PhamChinhCode/F1_PID_Driver_V1/F1_PID_Driver_V1.png

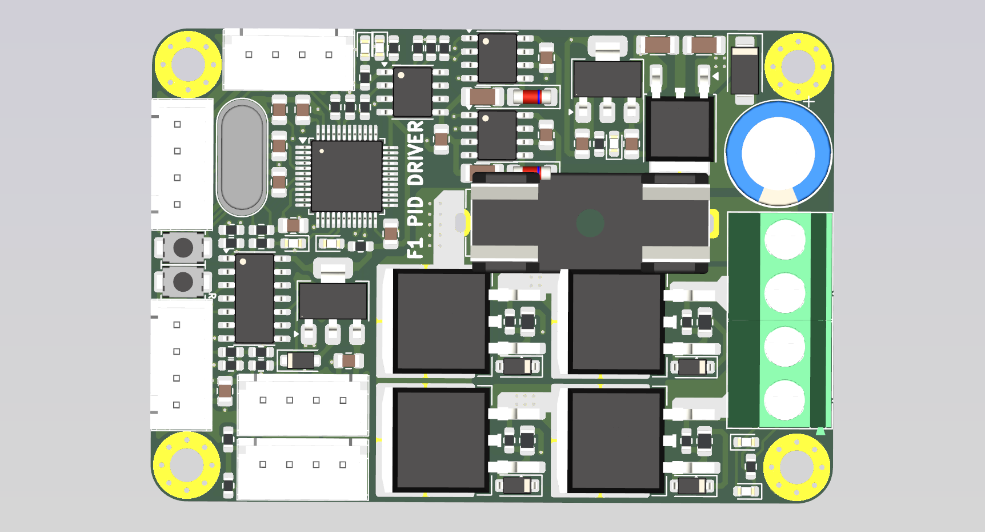
F1_PID_Driver_V1.png
