PhamChinhCode/F1_PID_Driver_V1/F1_PID_Driver_V1.pdf

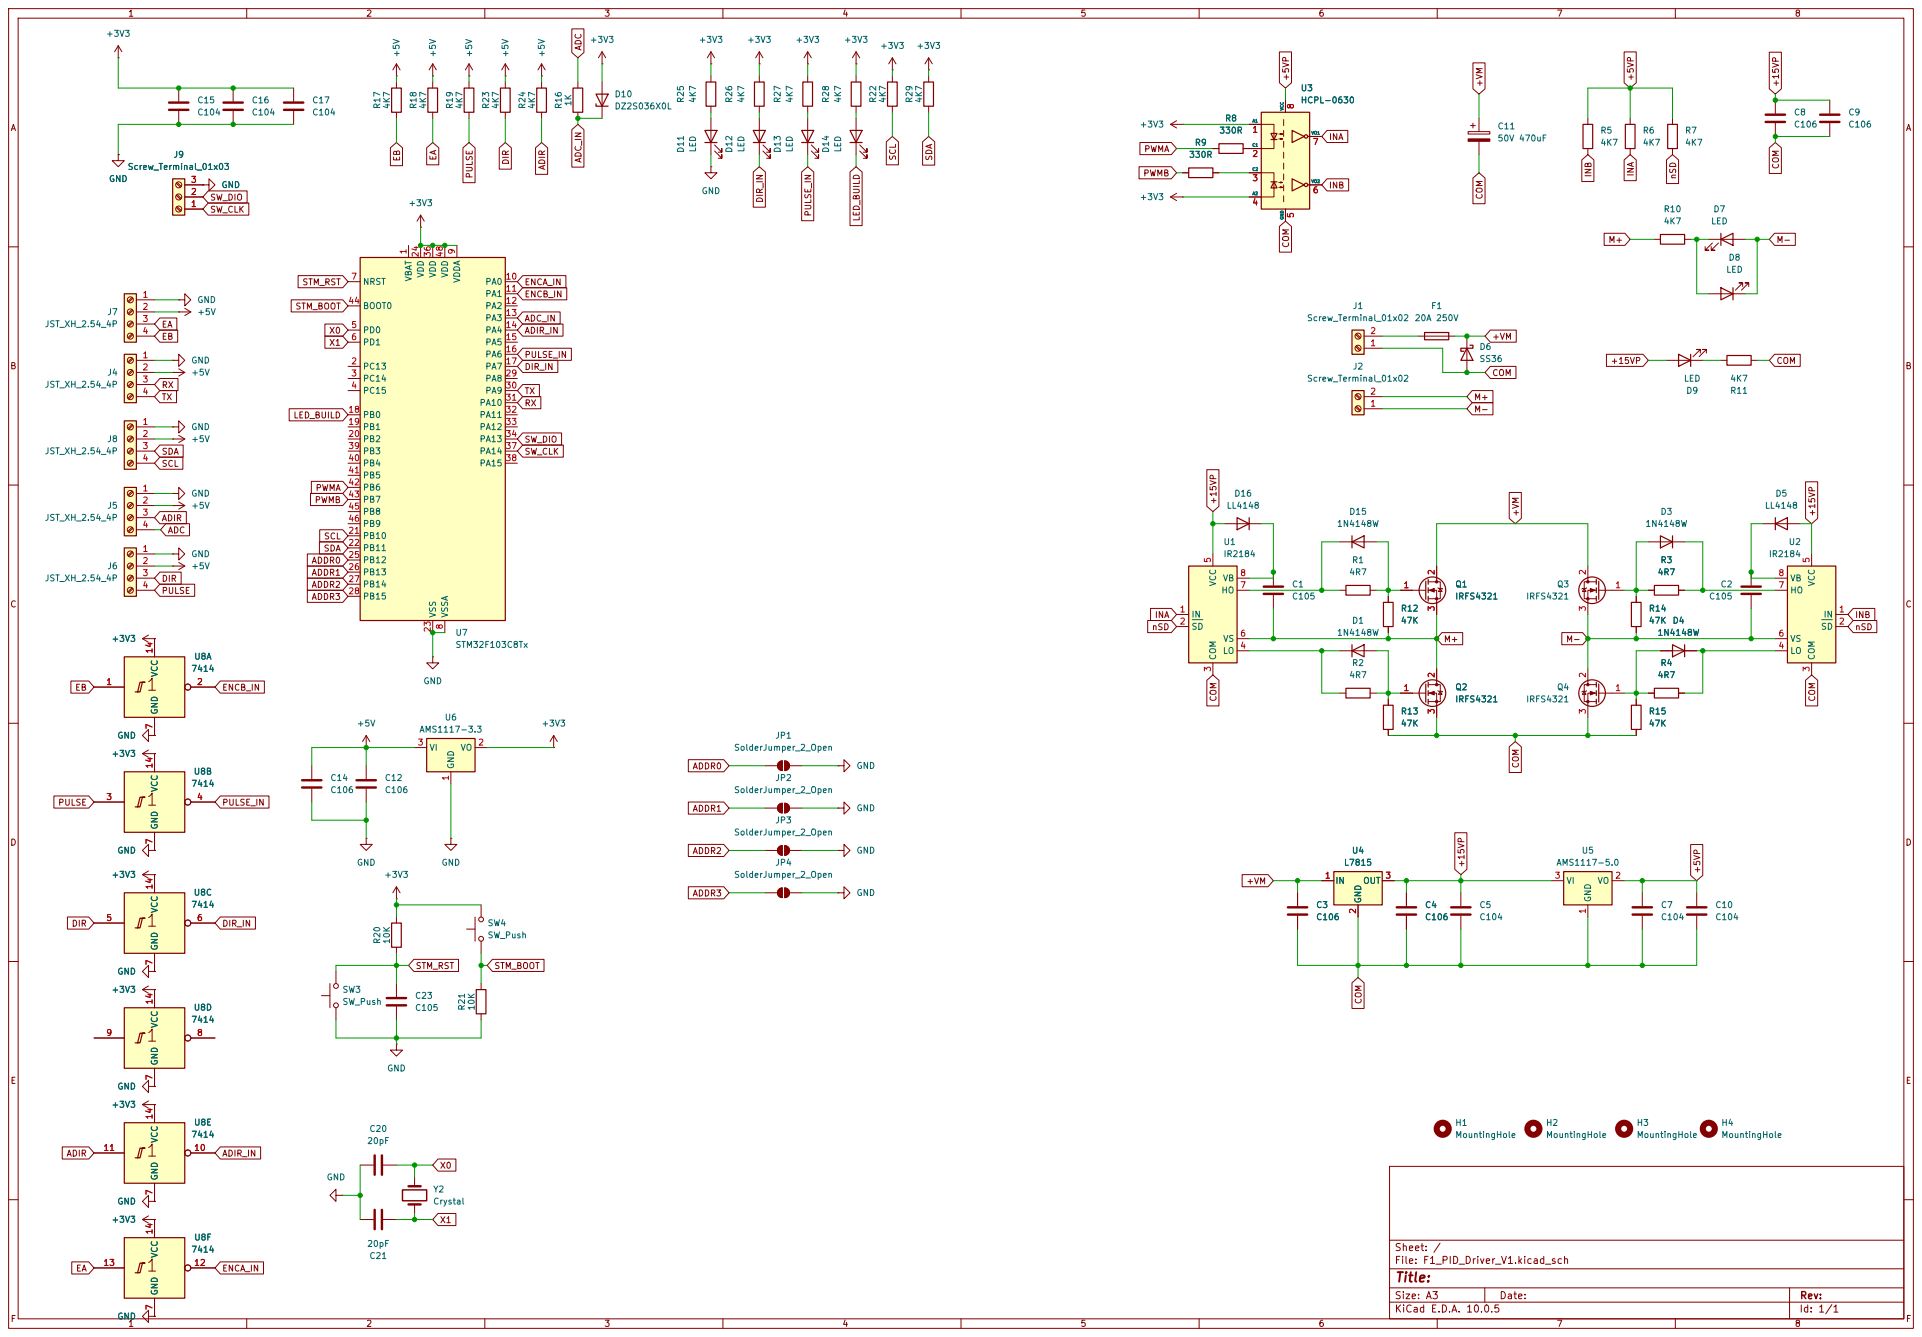
[picture p5: page 1]

Size: A3 | Rev: | F Date:
KiCad E.D.A. 10.0.5 | Id: 1/1
