PhamChinhCode/F1_PID_Driver_V1/PCB.pdf

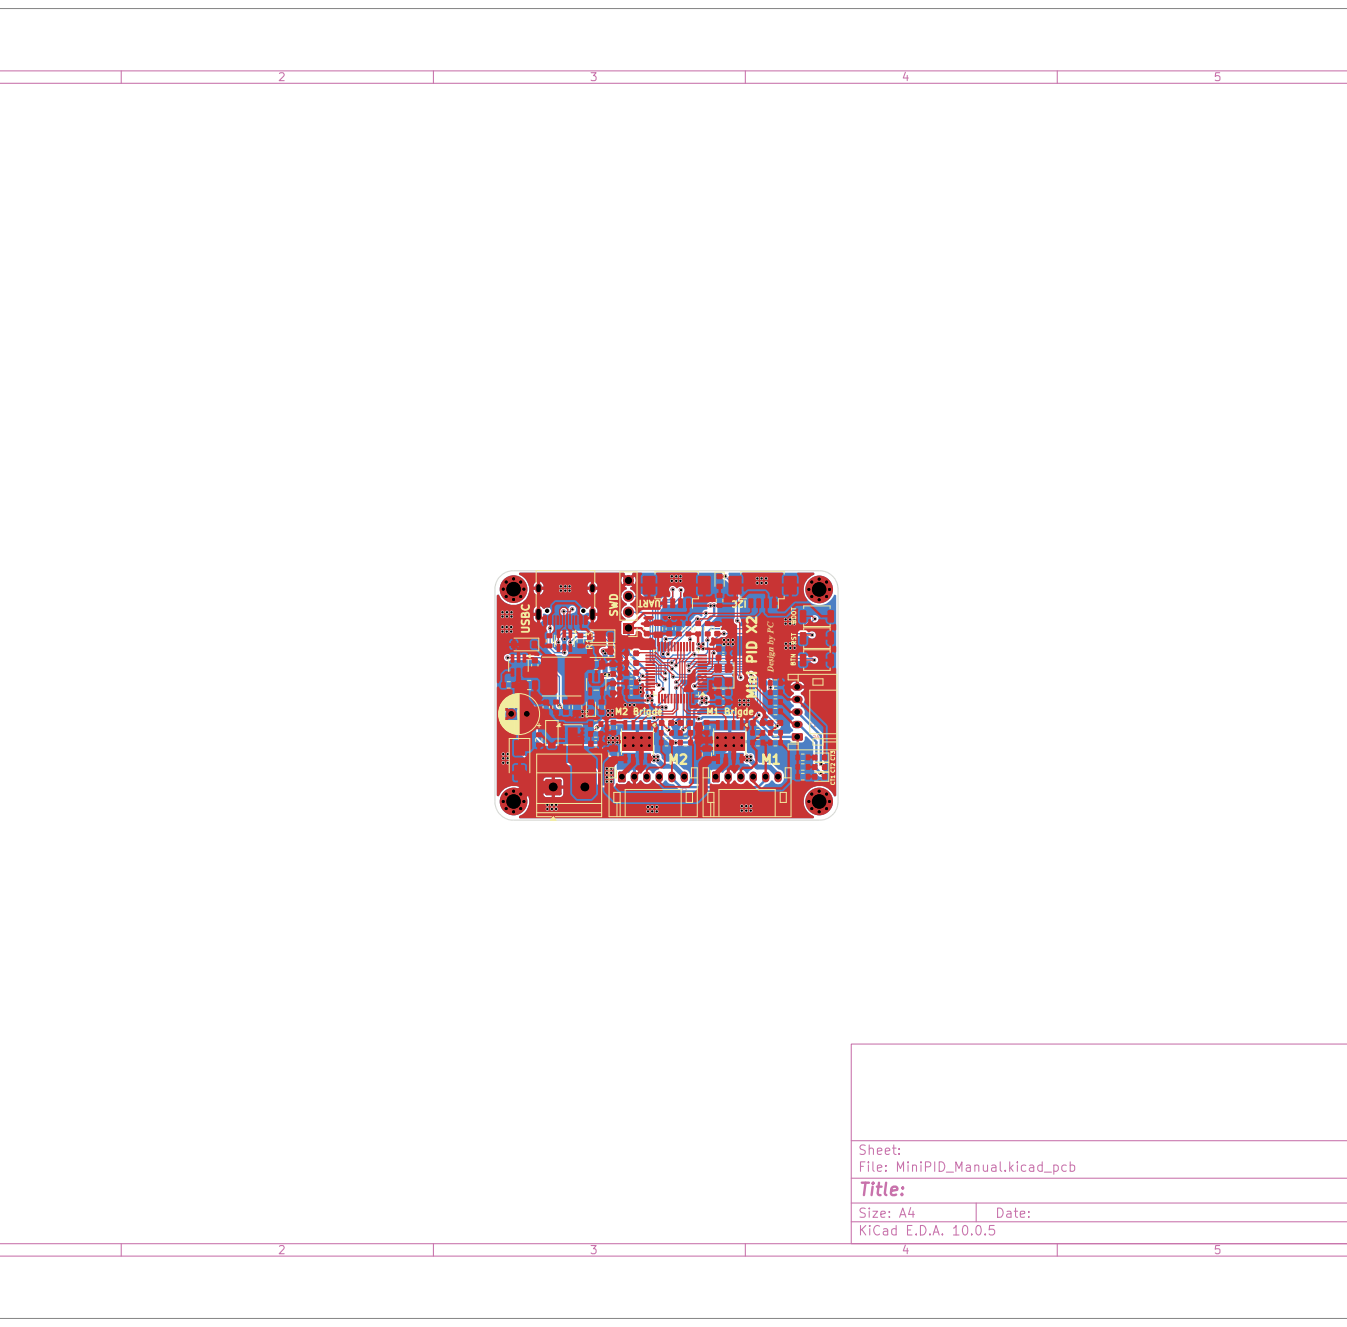
[picture p6: page 1]
