PhamChinhCode/F1_PID_Driver_V1/F1_PID_Driver_V1.kicad_pcb

## KiCad design F1_PID_Driver_V1.kicad_pcb (2026-11-10)

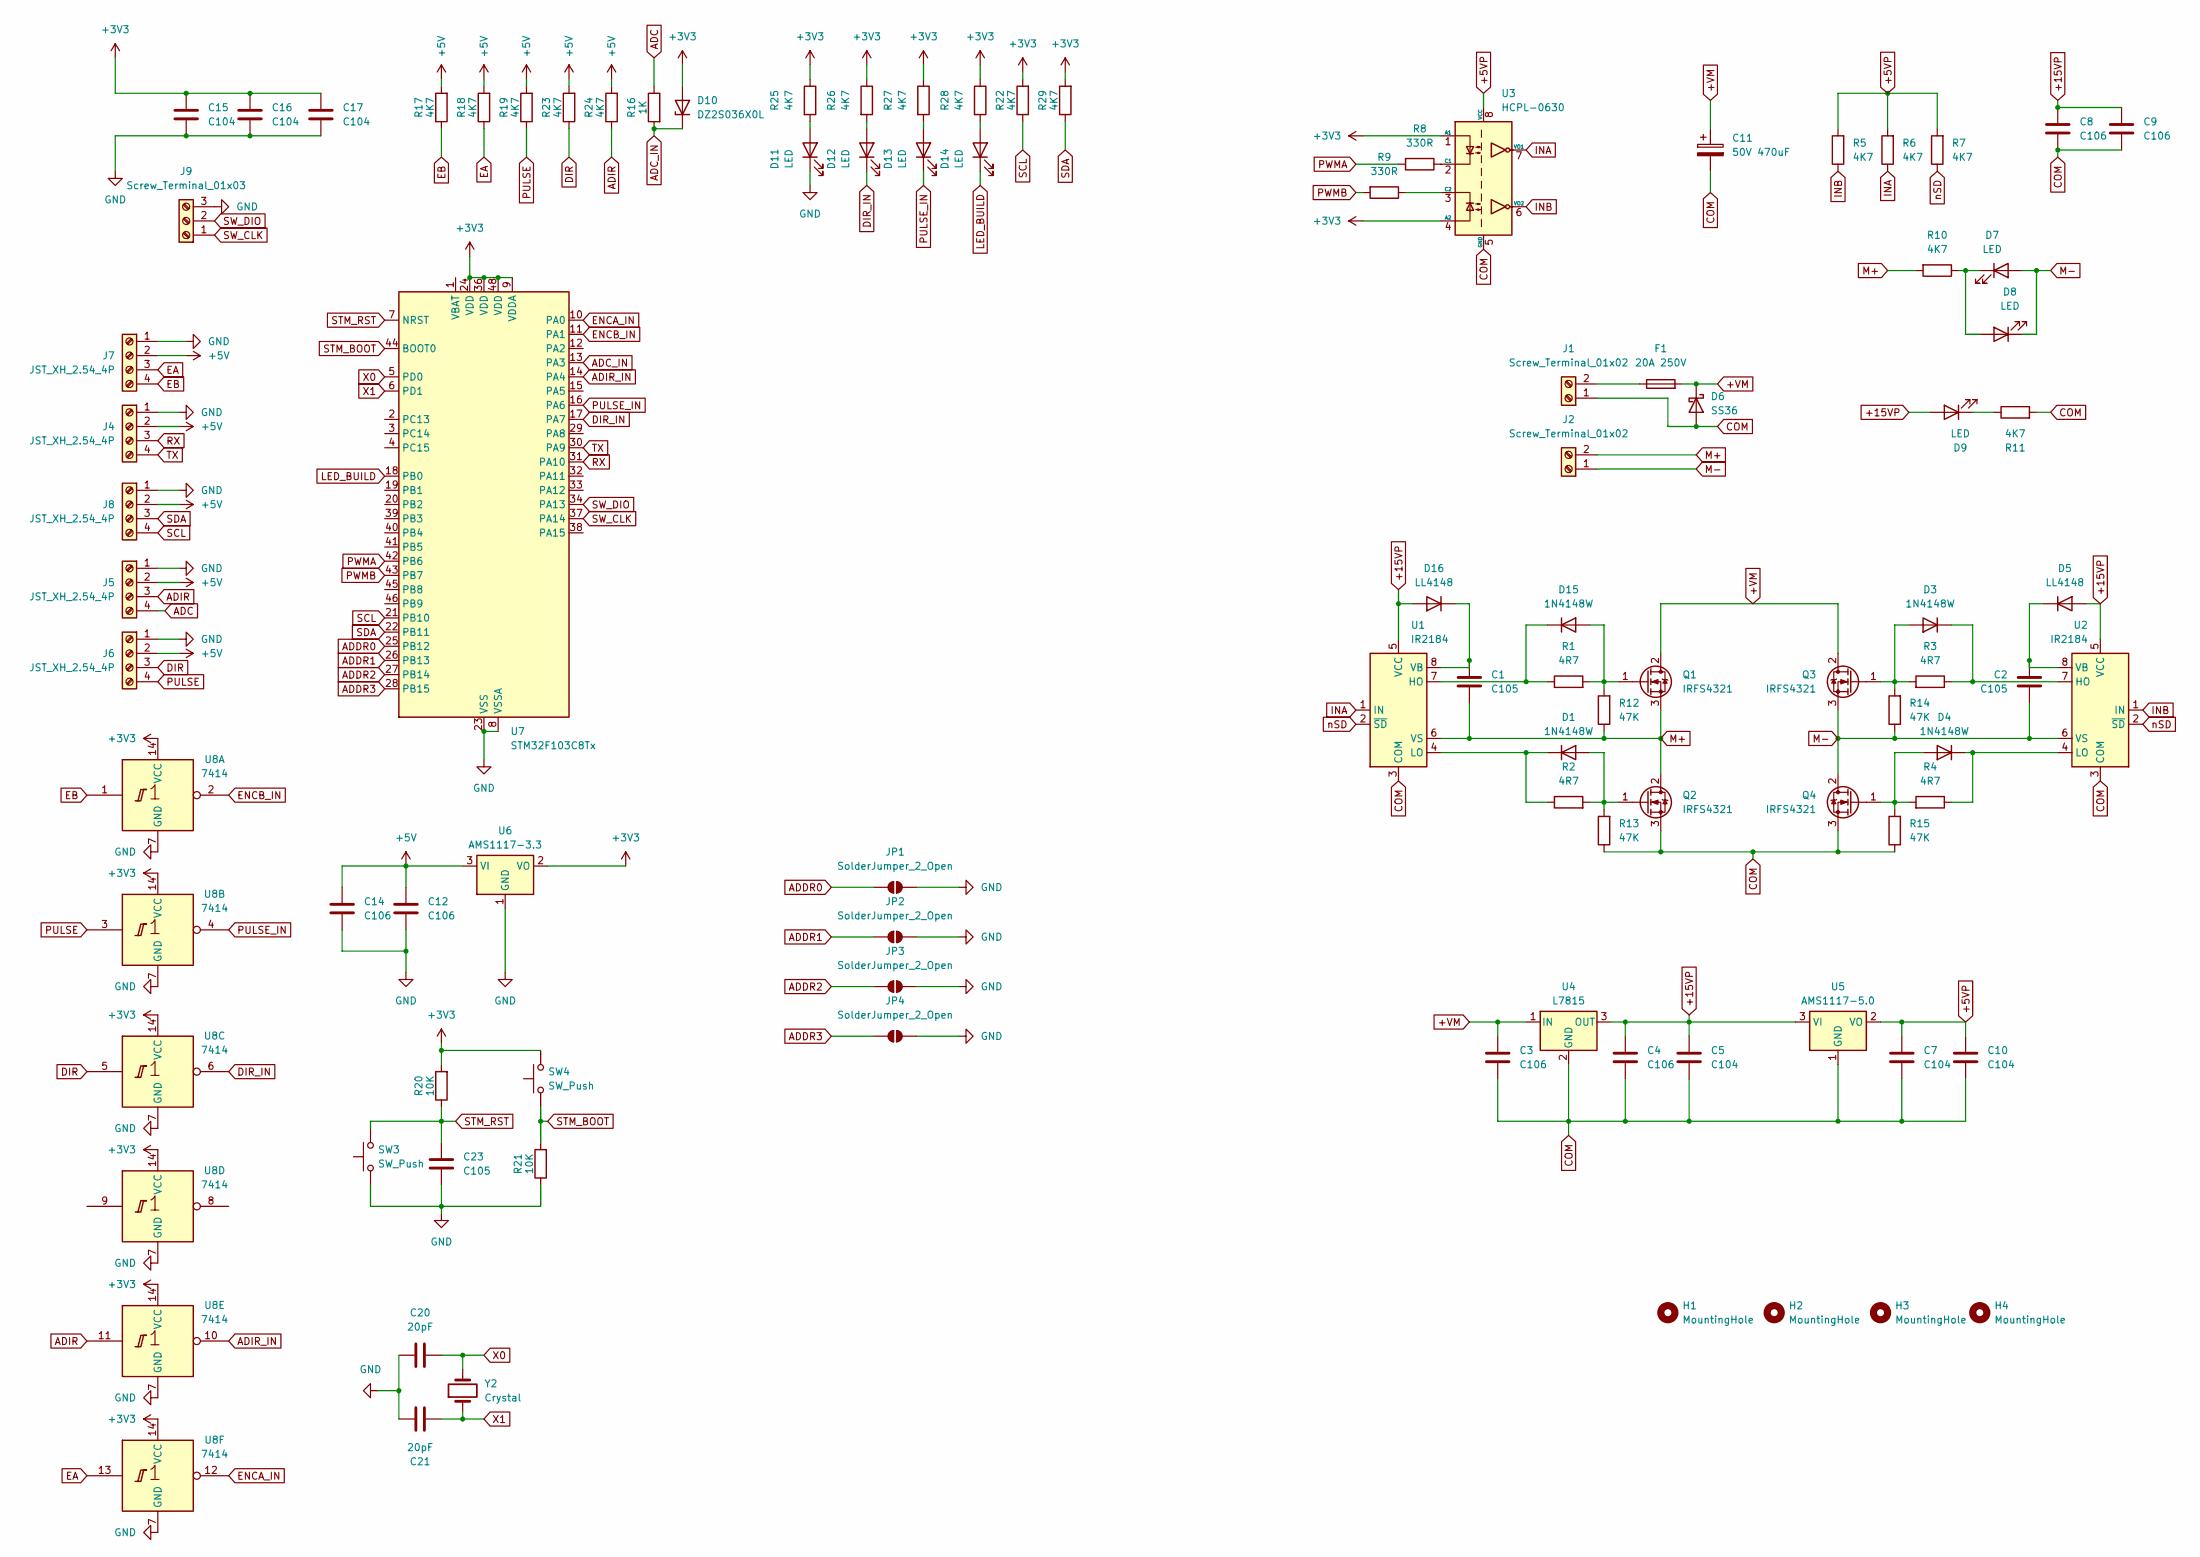
[picture p7: schematic F1_PID_Driver_V1.kicad_sch]

Parts:
C1, C2, C23: C105; C_0805_2012Metric
C3, C4, C8, C9: C106; C_1206_3216Metric
C5, C7, C10, C15, C16, C17: C104; C_0805_2012Metric
C11: 50V 470uF; CP_Radial_D10.0mm_P3.50mm
C12, C14: C106; C_0805_2012Metric
C20, C21: 20pF; C_0805_2012Metric
D1, D3, D4, D15: 1N4148W; D_SOD-123
D5, D16: LL4148; D_MiniMELF
D6: SS36; D_SMA
D7, D8, D9, D11, D12, D13, D14: LED; LED_0603_1608Metric
D10: DZ2S036X0L; D_SOD-123F
F1: 20A 250V; Fuseholder_Clip-5x20mm_Keystone_3512_Inline_P23.62x7.27mm_D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
H1, H2, H3, H4: MountingHole; MountingHole_3.2mm_M3_Pad_Via
J1, J2: Screw_Terminal_01x02; TerminalBlock_Phoenix_MKDS-1,5-2-5.08_1x02_P5.08mm_Horizont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
J4, J5, J6, J7, J8: JST_XH_2.54_4P; XH2.54-4P
J9: Screw_Terminal_01x03; JST_PH_B3B-PH-SM4-TB_1x03-1MP_P2.00mm_Vertical
JP1, JP2, JP3, JP4: SolderJumper_2_Open; SolderJumper-2_P1.3mm_Open_RoundedPad1.0x1.5mm
Q1, Q2, Q3, Q4: IRFS4321; TO-263-2
R1, R2, R3, R4: 4R7; R_0805_2012Metric
R5, R6, R7, R10, R11, R17, R18, R19, R22, R23, R24, R25, R26, R27, R28, R29: 4K7; R_0603_1608Metric
R8, R9: 330R; R_0603_1608Metric
R12, R13, R14, R15: 47K; R_0603_1608Metric
R16: 1K; R_0603_1608Metric
R20, R21: 10K; R_0603_1608Metric
SW3, SW4: SW_Push; SW_SPST_TS-1088-xR025
U1, U2: IR2184; SOIC-8_3.9x4.9mm_P1.27mm
U3: HCPL-0630; SOIC-8_3.9x4.9mm_P1.27mm
U4: L7815; TO-252-2
U5: AMS1117-5.0; SOT-223-3_TabPin2
U6: AMS1117-3.3; SOT-223-3_TabPin2
U7: STM32F103C8Tx; LQFP-48_7x7mm_P0.5mm
U8: 7414; SOIC-14_3.9x8.7mm_P1.27mm
Y2: Crystal; Crystal_HC49-4H_Vertical

Connections:
+3V3: C15.1, C16.1, C17.1, D10.2 (A), R20.2, R22.2, R25.1, R26.1, R27.1, R28.1, R29.2, SW4.2, U3.1 (A1), U3.4 (A2), U6.2 (VO), U7.9 (VDDA), U7.24 (VDD), U7.36 (VDD), U7.48 (VDD), U8.14 (VCC)
+5V: C12.1, C14.1, J4.2, J5.2, J6.2, J7.2, J8.2, R17.2, R18.2, R19.2, R23.2, R24.2, U6.3 (VI)
+5VP: C7.1, C10.1, R5.2, R6.2, R7.2, U3.8 (VCC), U5.2 (VO)
+15VP: C4.1, C5.1, C8.1, C9.1, D5.2 (A), D9.2 (A), D16.2 (A), U1.5 (VCC), U2.5 (VCC), U4.3 (OUT), U5.3 (VI)
+VM: C3.1, C11.1, D6.1 (K), F1.2, Q1.2 (D), Q3.2 (D), U4.1 (IN)
ADC: J5.4, R16.1
ADC_IN: D10.1 (K), R16.2, U7.13 (PA3)
ADDR0: JP1.1 (A), U7.25 (PB12)
ADDR1: JP2.1 (A), U7.26 (PB13)
ADDR2: JP3.1 (A), U7.27 (PB14)
ADDR3: JP4.1 (A), U7.28 (PB15)
ADIR: J5.3, R24.1, U8.11
ADIR_IN: U7.14 (PA4), U8.10
COM: C3.2, C4.2, C5.2, C7.2, C8.2, C9.2, C10.2, C11.2, D6.2 (A), J1.1, Q2.3 (S), Q4.3 (S), R11.2, R13.1, R15.1, U1.3 (COM), U2.3 (COM), U3.5 (GND), U4.2 (GND), U5.1 (GND)
DIR: J6.3, R23.1, U8.5
DIR_IN: D12.1 (K), U7.17 (PA7), U8.6
EA: J7.3, R18.1, U8.13
EB: J7.4, R17.1, U8.1
ENCA_IN: U7.10 (PA0), U8.12
ENCB_IN: U7.11 (PA1), U8.2
GND: C12.2, C14.2, C15.2, C16.2, C17.2, C20.1, C21.1, C23.2, D11.1 (K), J4.1, J5.1, J6.1, J7.1, J8.1, J9.3, JP1.2 (B), JP2.2 (B), JP3.2 (B), JP4.2 (B), R21.1, SW3.1, U6.1 (GND), U7.8 (VSSA), U7.23 (VSS), U7.35 (VSS), U7.47 (VSS), U8.7 (GND)
INA: R6.1, U1.1 (IN), U3.7 (VO1)
INB: R5.1, U2.1 (IN), U3.6 (VO2)
LED_BUILD: D14.1 (K), U7.18 (PB0)
M+: C1.2, J2.2, Q1.3 (S), Q2.2 (D), R10.2, R12.1, U1.6 (VS)
M-: C2.2, D7.2 (A), D8.1 (K), J2.1, Q3.3 (S), Q4.2 (D), R14.1, U2.6 (VS)
unnamed: D1.2 (A), Q2.1 (G), R2.2, R13.2
unnamed: D1.1 (K), R2.1, U1.4 (LO)
unnamed: D3.2 (A), Q3.1 (G), R3.2, R14.2
unnamed: D3.1 (K), R3.1, U2.7 (HO)
unnamed: D4.2 (A), Q4.1 (G), R4.2, R15.2
unnamed: D4.1 (K), R4.1, U2.4 (LO)
unnamed: C2.1, D5.1 (K), U2.8 (VB)
unnamed: D7.1 (K), D8.2 (A), R10.1
unnamed: D9.1 (K), R11.1
unnamed: D11.2 (A), R25.2
unnamed: D12.2 (A), R26.2
unnamed: D13.2 (A), R27.2
unnamed: D14.2 (A), R28.2
unnamed: D15.2 (A), Q1.1 (G), R1.2, R12.2
unnamed: D15.1 (K), R1.1, U1.7 (HO)
unnamed: C1.1, D16.1 (K), U1.8 (VB)
unnamed: F1.1, J1.2
unnamed: R8.1, U3.2 (C1)
unnamed: R9.1, U3.3 (C2)
PULSE: J6.4, R19.1, U8.3
PULSE_IN: D13.1 (K), U7.16 (PA6), U8.4
PWMA: R8.2, U7.42 (PB6)
PWMB: R9.2, U7.43 (PB7)
RX: J4.3, U7.31 (PA10)
SCL: J8.4, R22.1, U7.21 (PB10)
SDA: J8.3, R29.1, U7.22 (PB11)
STM_BOOT: R21.2, SW4.1, U7.44 (BOOT0)
STM_RST: C23.1, R20.1, SW3.2, U7.7 (NRST)
SW_CLK: J9.1, U7.37 (PA14)
SW_DIO: J9.2, U7.34 (PA13)
TX: J4.4, U7.30 (PA9)
X0: C20.2, U7.5 (PD0), Y2.2
X1: C21.2, U7.6 (PD1), Y2.1
nSD: R7.1, U1.2 (~SD), U2.2 (~SD)

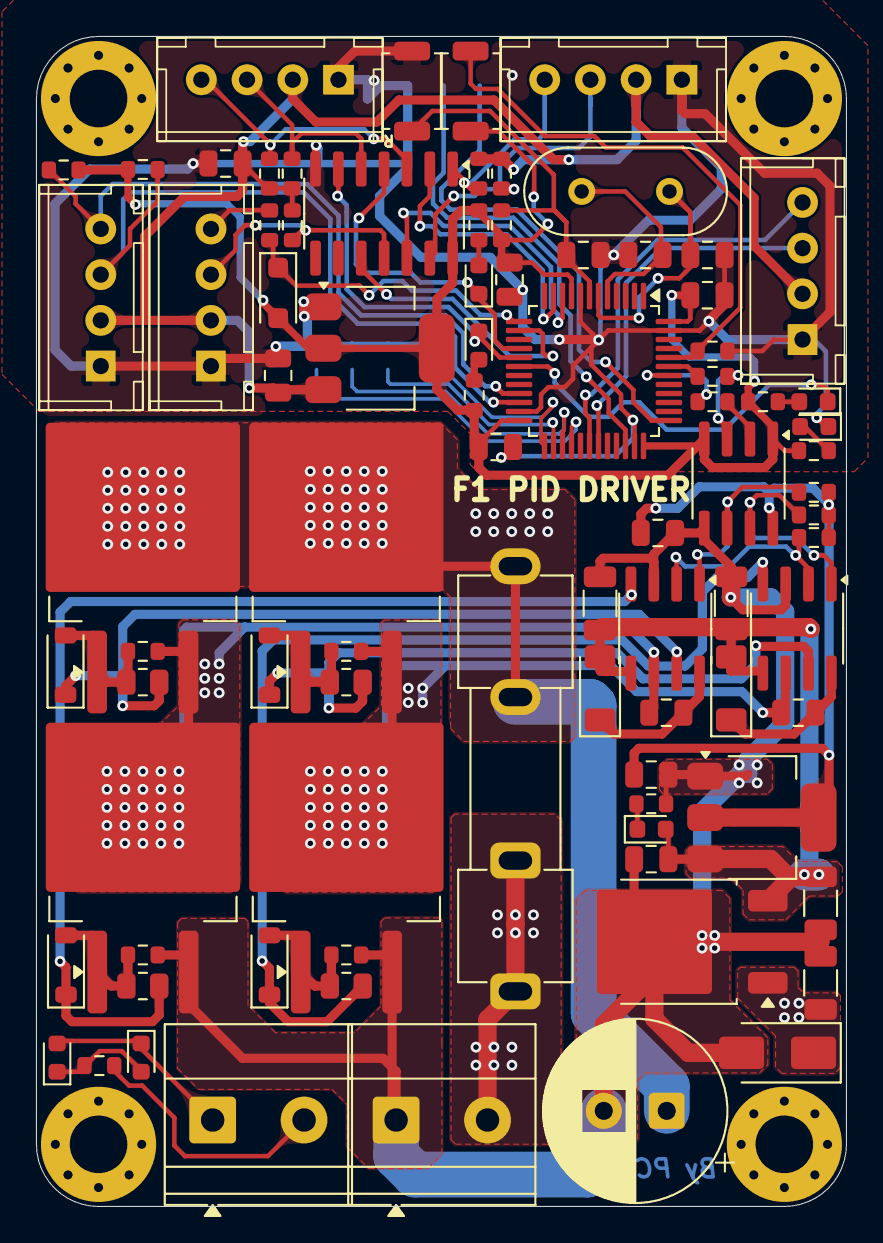
[picture p8: board F1_PID_Driver_V1.kicad_pcb from above]

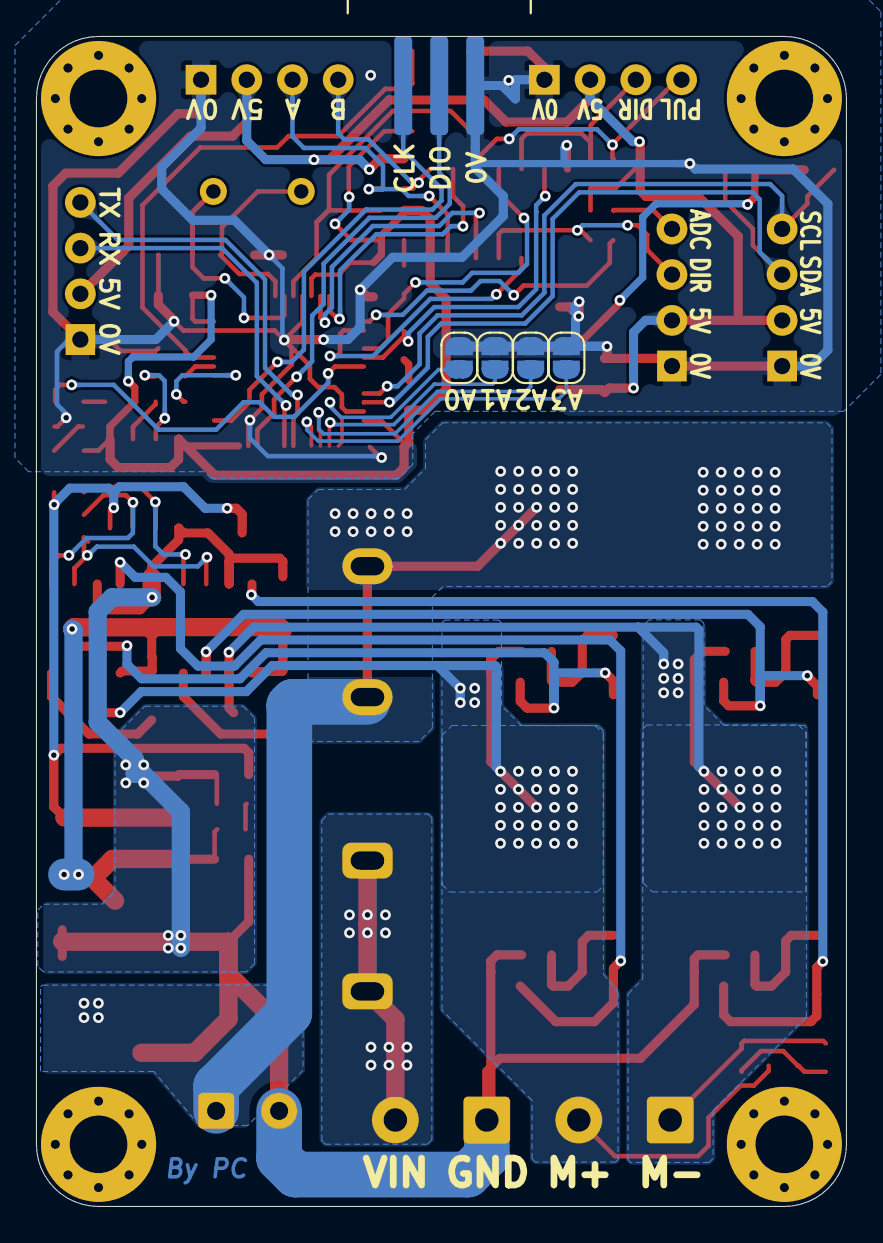
[picture p9: board F1_PID_Driver_V1.kicad_pcb from below]

Board: 2 copper layers, 45.0 x 65.0 mm, 94 parts (5 on the bottom side), 60 nets.
