PhamChinhCode/F1_PID_Driver_V1/(commit log)

2026-11-10 Initial commit: F1_PID_Driver_V1 KiCad project with README
    [F1_PID_Driver_V1.kicad_pcb, F1_PID_Driver_V1.kicad_sch]
2026-11-10 add pcb pdf
